vuviethoang2k4-source/motorcycle-anti-theft-system/hardware/schematic/final/machtrungtam.pdf

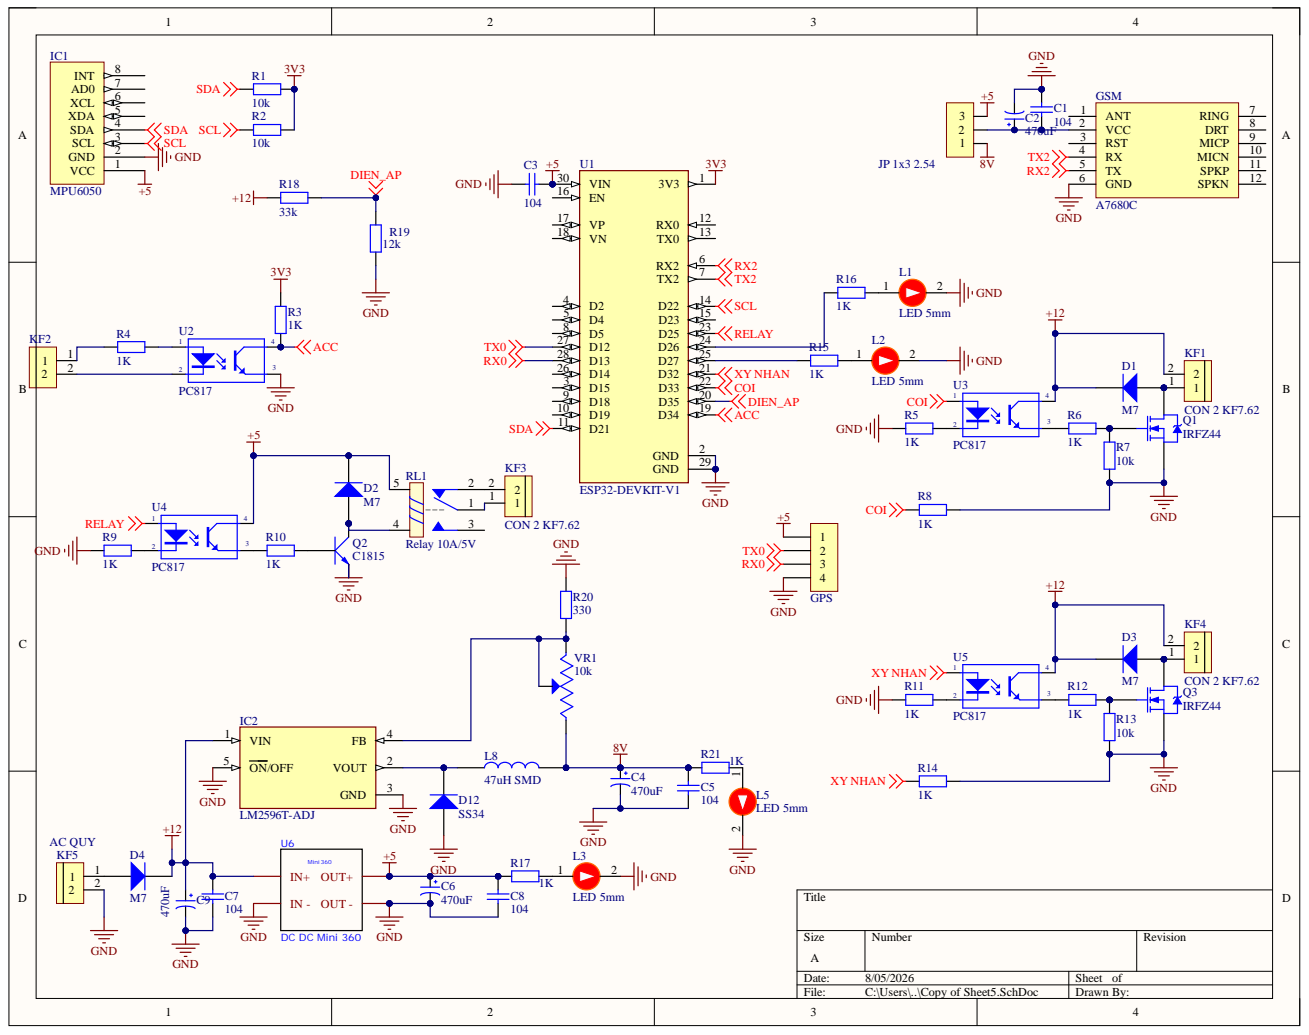
[picture p1: page 1]
