vuviethoang2k4-source/motorcycle-anti-theft-system/hardware/schematic/final/remote.pdf

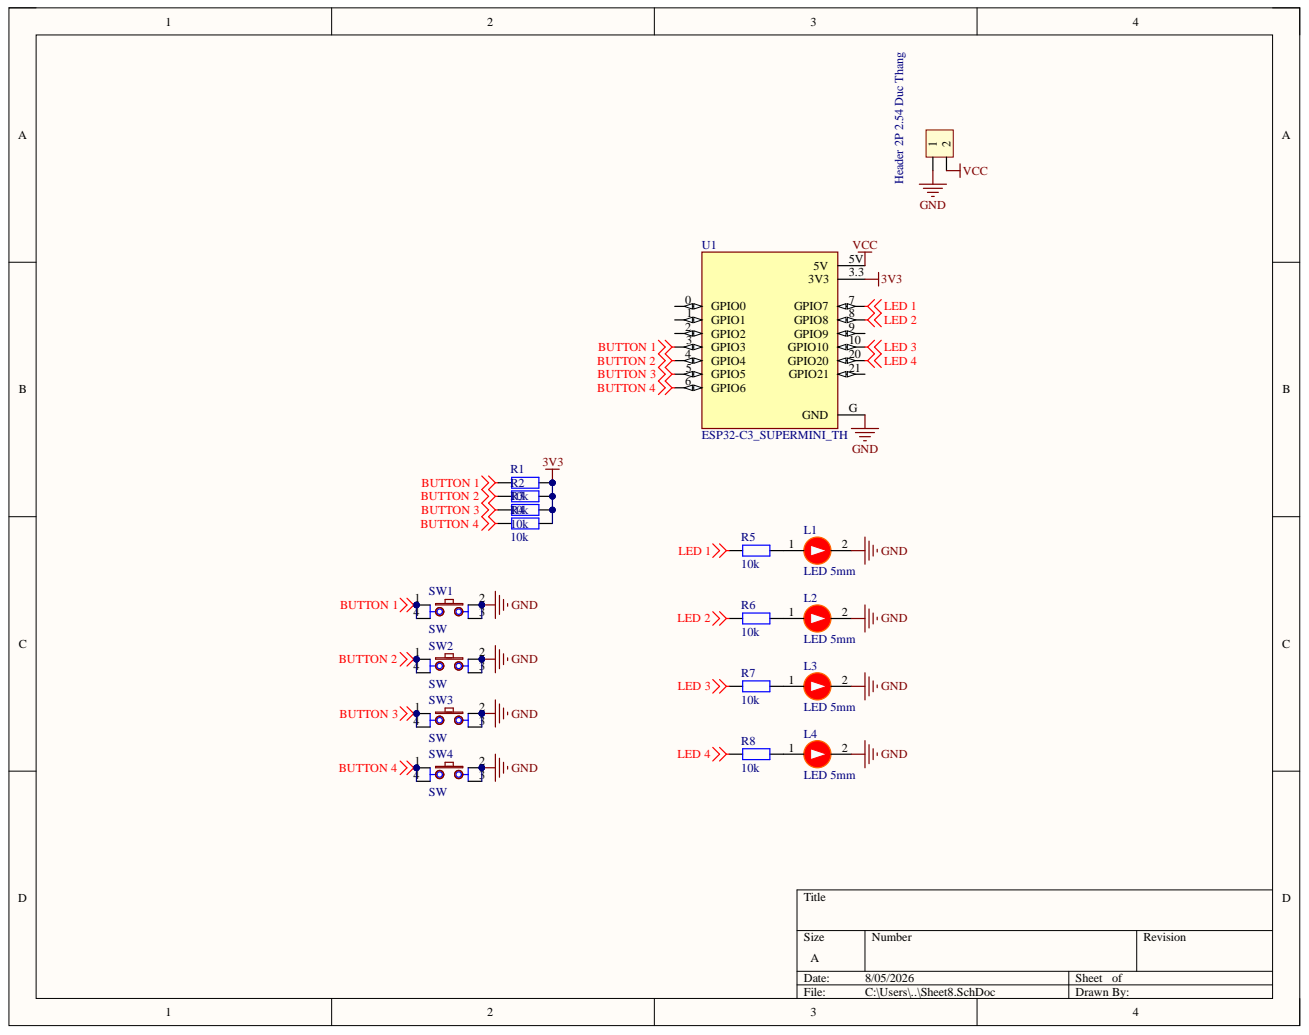
[picture p2: page 1]
