vuviethoang2k4-source/motorcycle-anti-theft-system/firmware/main_controller/output_controller.h

#pragma once

namespace OutputController {
void begin();
void setStarterLocked(bool locked);
void setSiren(bool enabled);
void setTurnSignal(bool enabled);
void stopWarningOutputs();
bool isStarterLocked();
bool isSirenEnabled();
bool isTurnSignalEnabled();
}
