vuviethoang2k4-source/motorcycle-anti-theft-system/firmware/remote_controller/remote_io.h

#pragma once
#include "protocol.h"

namespace RemoteIo {
void begin();
void update();
bool getPendingCommand(RemoteCommand &command);
void showCommandSuccess(RemoteCommand command);
void showCommunicationFailure();
void allLedsOff();
}
