vuviethoang2k4-source/motorcycle-anti-theft-system/firmware/main_controller/secrets.example.h

#pragma once
#include <Arduino.h>

constexpr char OWNER_PHONE_NUMBER[] = "+84xxxxxxxxx";

constexpr uint8_t REMOTE_MAC_ADDRESS[6] = {
    0x00, 0x00, 0x00, 0x00, 0x00, 0x00
};

constexpr uint32_t ESPNOW_SHARED_SECRET = 0xA5C37E19UL;
