vuviethoang2k4-source/motorcycle-anti-theft-system/(commit log)

2026-08-05 Add project structure and final schematics
    Add initial firmware files and finalized schematics for the main controller and remote.
2026-08-05 Add anti-theft state machine
    Implement ARM, DISARM, FIND and SILENCE states with starter lock, siren and right turn-signal control.
2026-08-05 Add MPU6050 motion detection
    Add modular MPU6050 monitoring, baseline calibration, vibration detection and tilt-based alarm triggering.
    [config.h, main_controller.ino, motion_sensor.cpp, motion_sensor.h, state_machine.cpp]
2026-08-05 Add modular GPS support
    Add UART1 GPS communication, TinyGPSPlus NMEA parsing, location status and Google Maps URL generation.
2026-08-05 Add persistent anti-theft state storage
    Store ARM and DISARM state in ESP32 NVS and restore the anti-theft mode after power loss.
2026-08-05 Add battery voltage monitoring
    Add filtered battery ADC measurement, divider conversion, calibration support and battery voltage reporting in SMS status.
2026-08-05 Improve ESP-NOW command reliability
    Prevent duplicate command execution, resend cached acknowledgements, and persist the remote packet ID in NVS.
    [espnow_manager.cpp, espnow_remote.cpp]
